DavidMFlynn/DCC-Booster/Case/CaseTop.stl

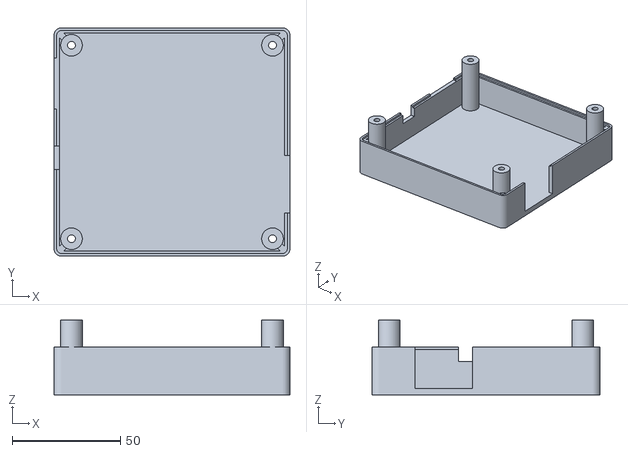
[picture p1: CAD file, 2020-07-25]
Case/CaseTop.stl
109.0 x 105.5 x 34.6
