DavidMFlynn/DCC-Booster/Case/CaseBottom.stl

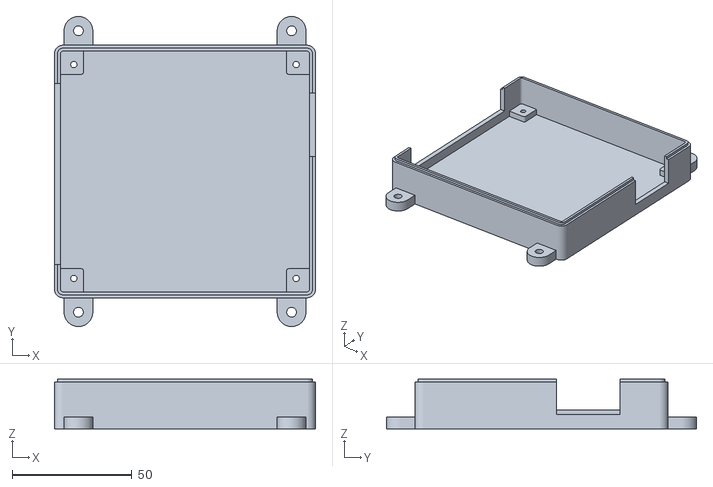
[picture p2: CAD file, 2020-07-03]
Case/CaseBottom.stl
109.0 x 129.5 x 20.8
