DavidMFlynn/DCC-Booster/DCC_Booster Rev B PCB/DCC_BoosterB.sch.pdf

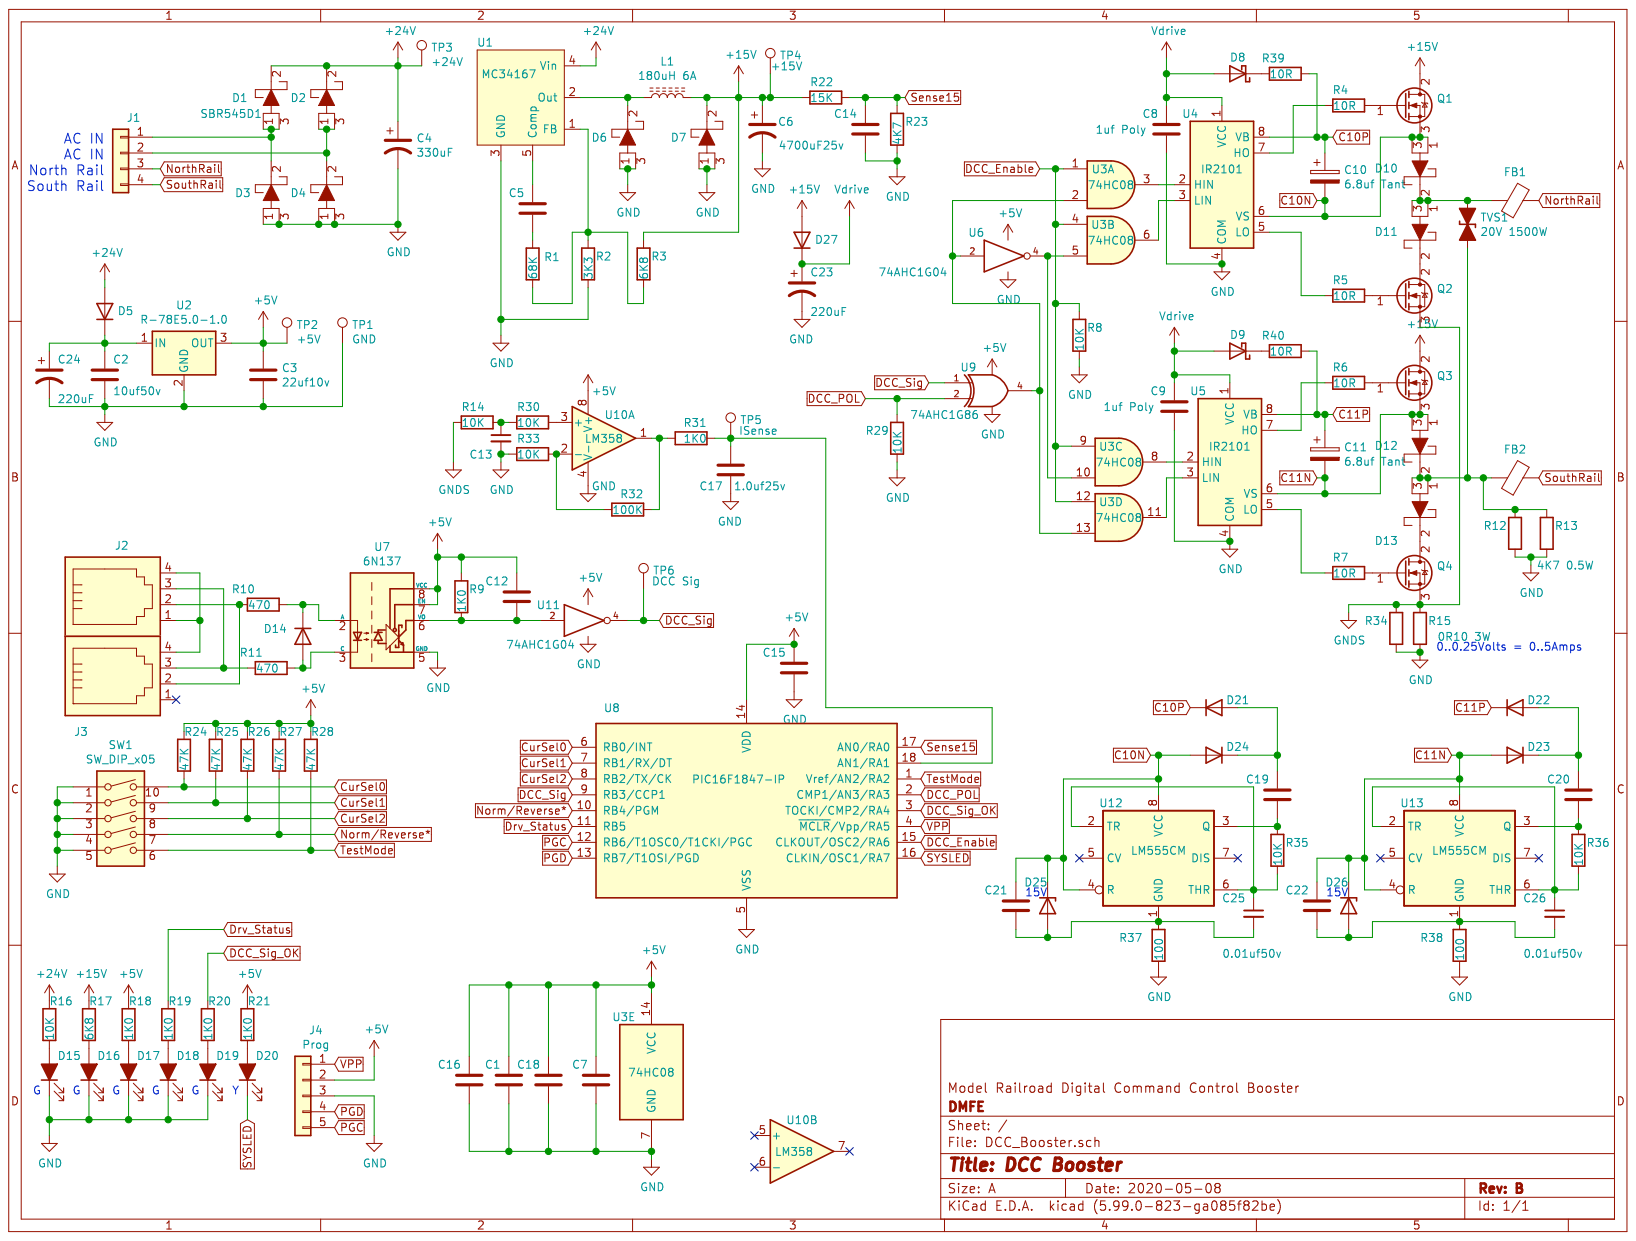
[picture p3: page 1]
