DavidMFlynn/DCC-Booster/DCC_Booster PCB/DCC_Booster.sch.pdf

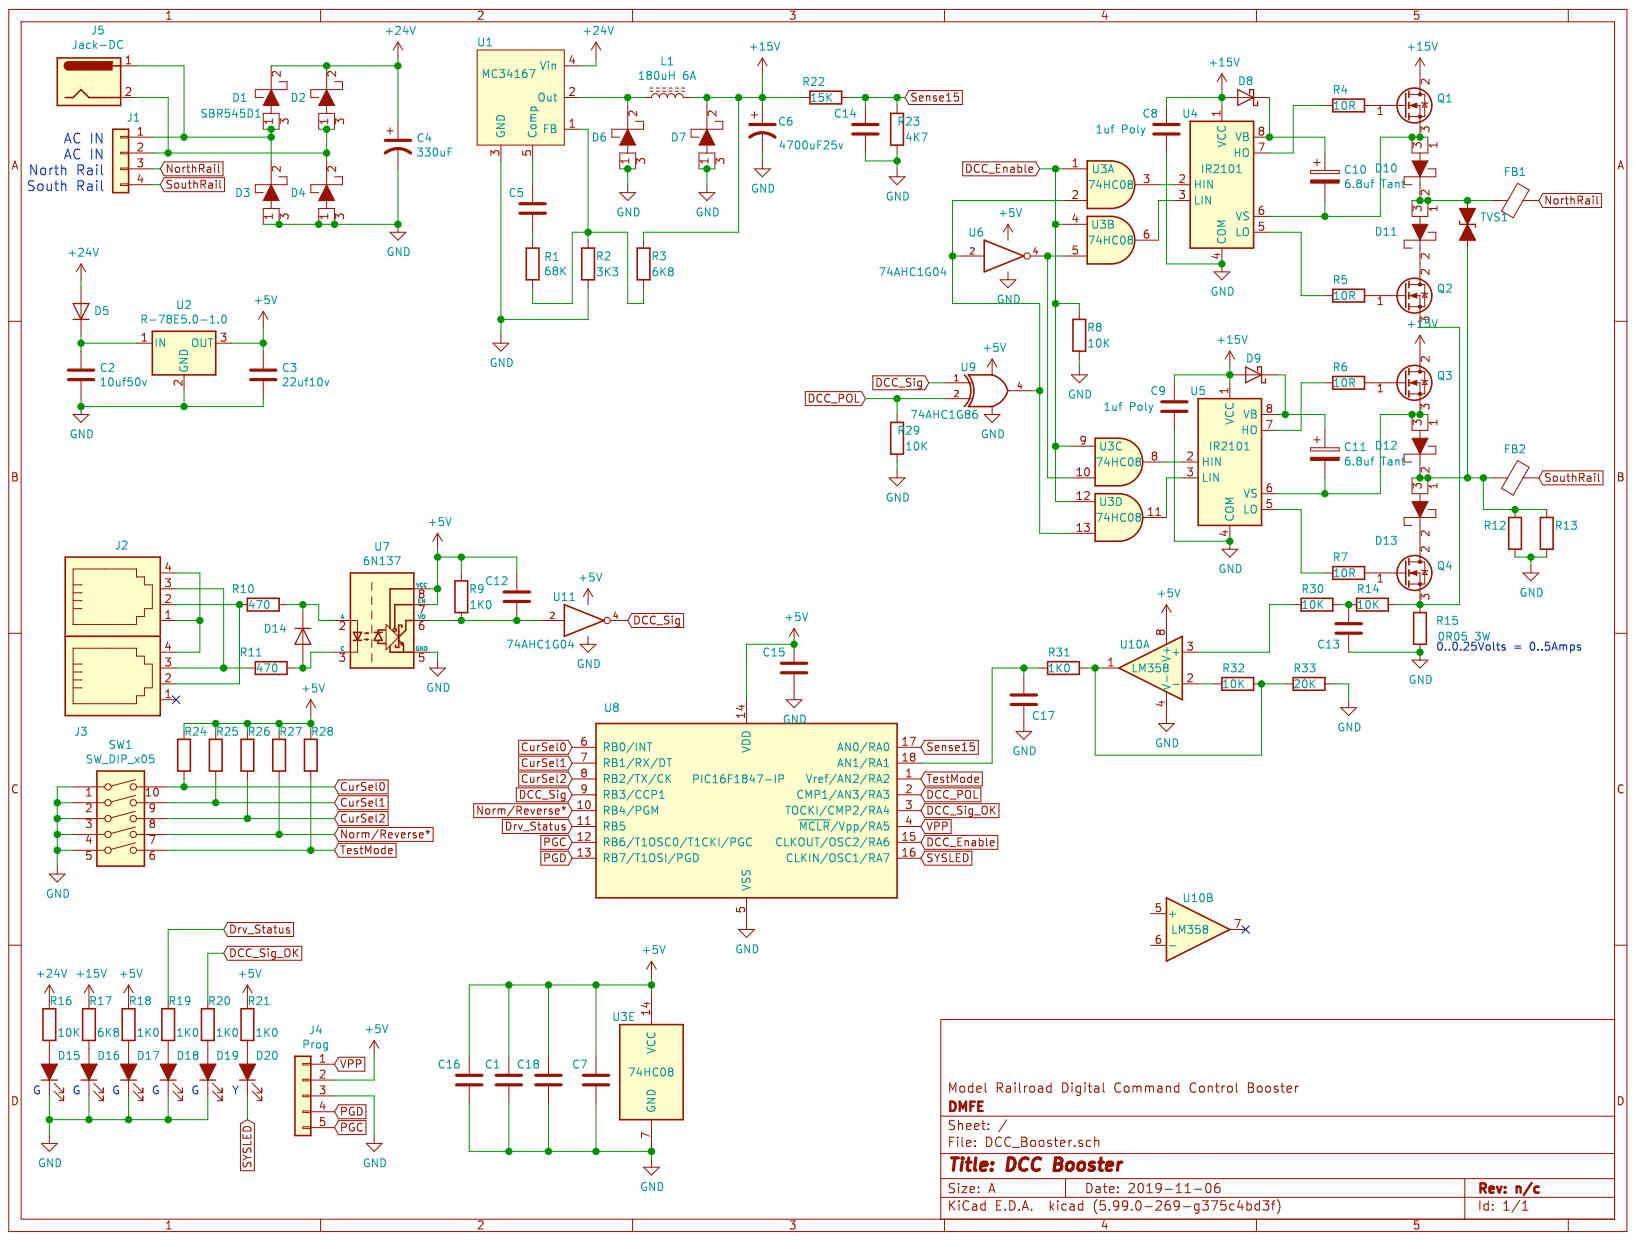
[picture p4: page 1]
