DavidMFlynn/DCC-Booster/DCC_Booster Rev C PCB/DCC_Booster.kicad_pcb

## KiCad design DCC_Booster Rev C PCB/DCC_Booster.kicad_pcb (2021-07-31)

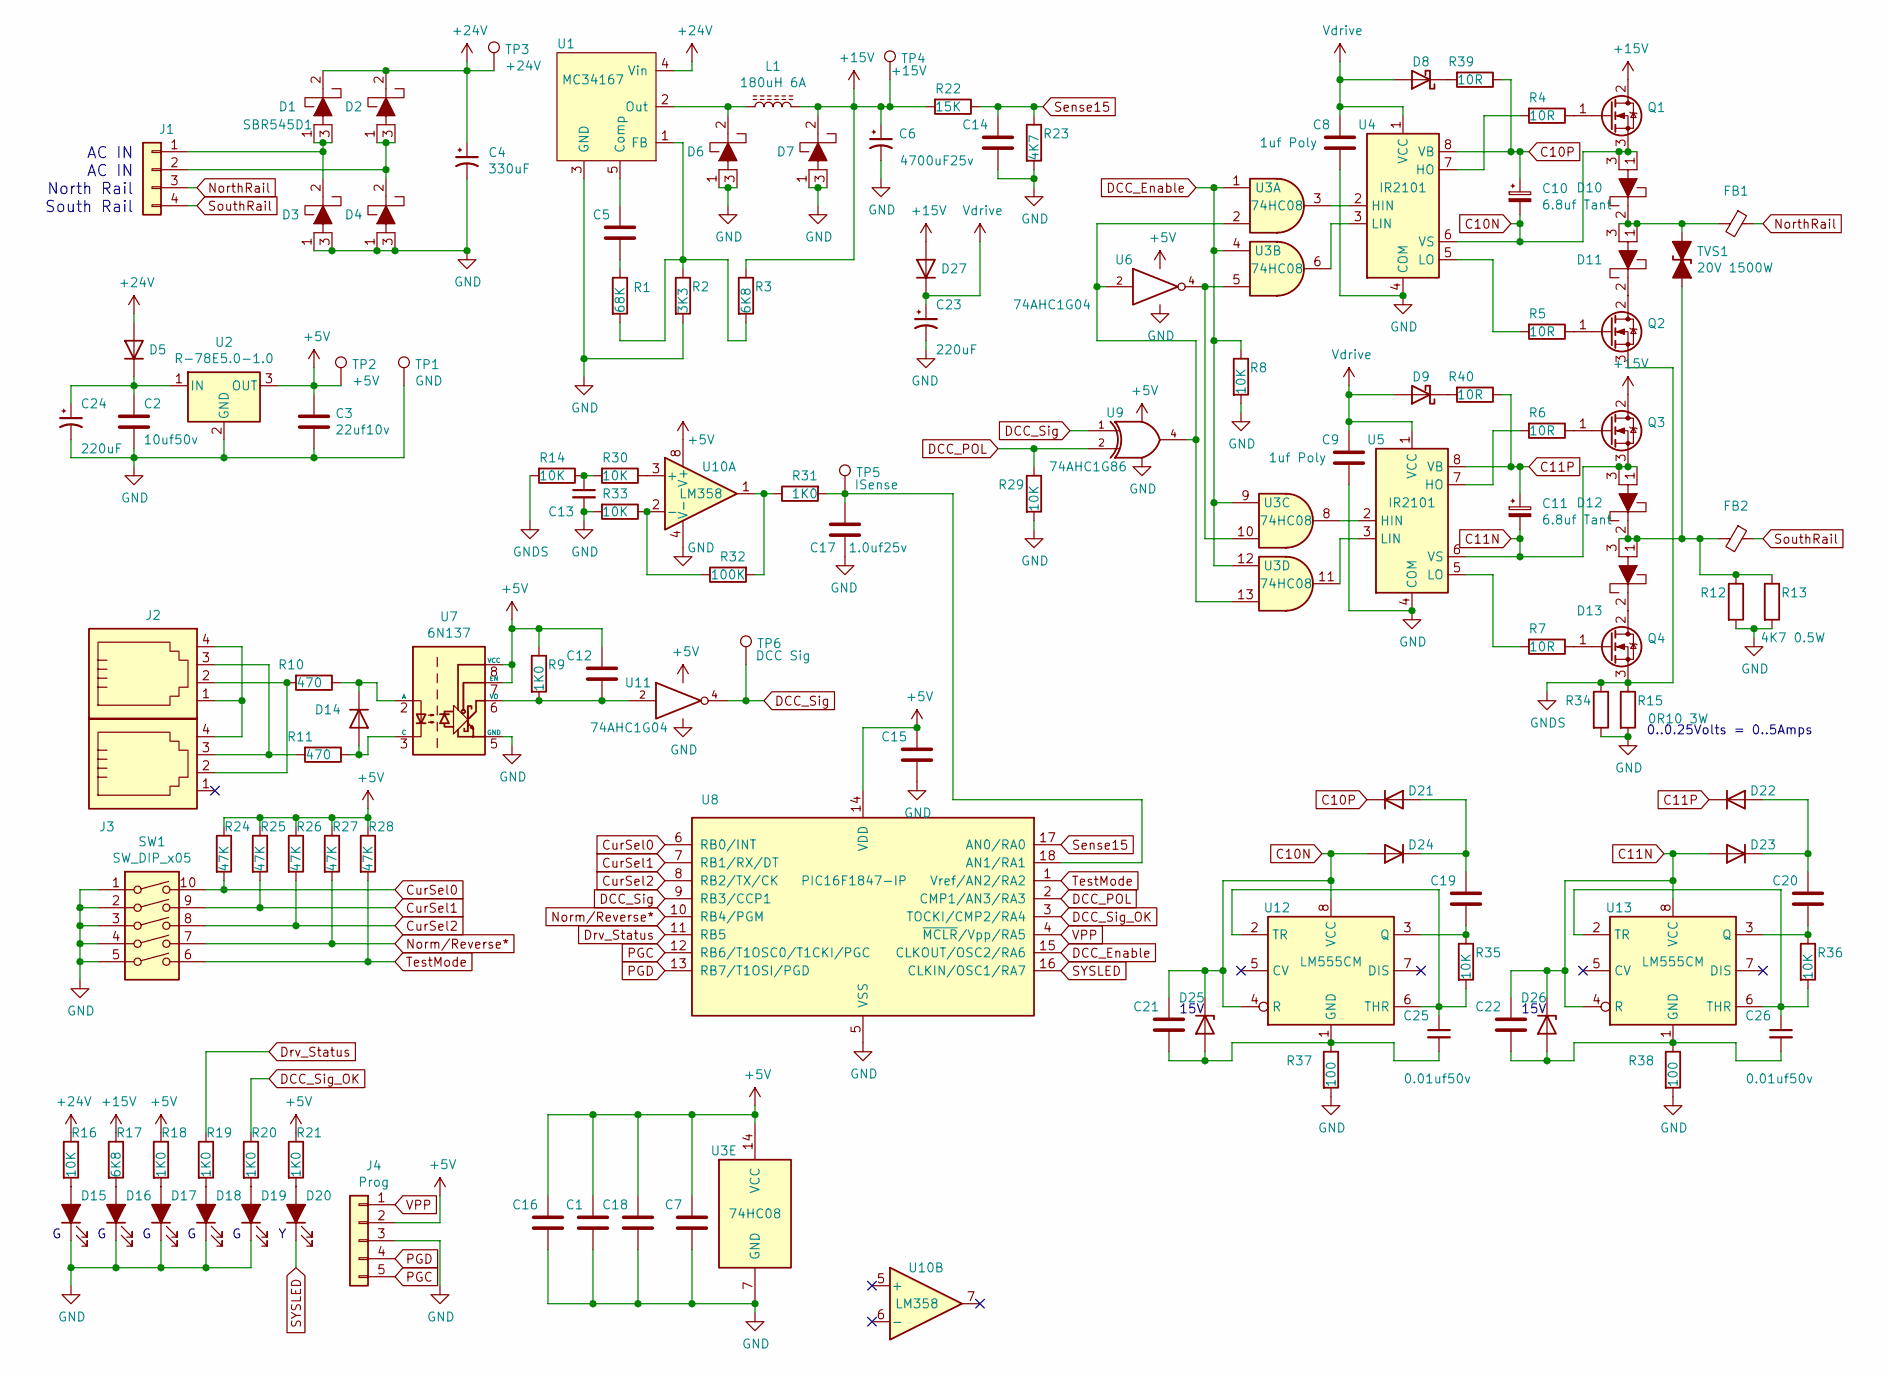
[picture p5: schematic DCC_Booster.kicad_sch, DCC Booster]

Parts:
C1, C5, C7, C12, C13, C14, C15, C16, C18, C19, C20, C21, C22: 0.1uf50v; C_0805_2012Metric_Pad1.15x1.40mm_HandSolder
C2: 10uf50v; C_1210_3225Metric_Pad1.42x2.65mm_HandSolder
C3: 22uf10v; C_1210_3225Metric_Pad1.42x2.65mm_HandSolder
C4: 330uF; CP_Radial_D18.0mm_P7.50mm
C6: 4700uF25v; CP_Radial_D18.0mm_P7.50mm
C8, C9: 1uf Poly; C_Rect_L7.0mm_W6.0mm_P5.00mm
C10, C11: 6.8uf Tant; CP_EIA-3528-21_Kemet-B_Pad1.50x2.35mm_HandSolder
C17: 1.0uf25v; C_0805_2012Metric_Pad1.15x1.40mm_HandSolder
C23, C24: 220uF; CP_Elec_10x10
C25, C26: 0.01uf50v; C_0805_2012Metric_Pad1.15x1.40mm_HandSolder
D1, D2, D3, D4, D6, D7, D10, D11, D12, D13: SBR545D1; TO-252-2
D5, D27: MRA4003T3G; D_SMA
D8, D9: B140-E3; D_SOD-123
D14: 1N4148; D_SOD-123
D15, D16, D17, D18, D19, D20: LED_ALT; LED_D3.0mm
D21, D22, D23, D24: 1N4148W; D_SOD-123
D25, D26: BZT52C15; D_SOD-123
FB1, FB2: Ferrite_Bead; L_1812_4532Metric_Pad1.30x3.40mm_HandSolder
J1: Conn_01x04; PhoenixContact_MC_1,5_4-G-5.08_1x04_P5.08mm_Horizontal
J2, J3: 4P4C; RJ9
J4: Prog; PinHeader_1x05_P2.54mm_Vertical
L1: 180uH 6A; L_Radial_D24.4mm_P23.70mm_muRATA_1400series
Q1, Q2, Q3, Q4: Q_NMOS_GDS; TO-252-2
R1: 68K; R_0805_2012Metric_Pad1.15x1.40mm_HandSolder
R2: 3K3; R_0805_2012Metric_Pad1.15x1.40mm_HandSolder
R3, R17: 6K8; R_0805_2012Metric_Pad1.15x1.40mm_HandSolder
R4, R5, R6, R7, R39, R40: 10R; R_0805_2012Metric_Pad1.15x1.40mm_HandSolder
R8, R14, R16, R29, R30, R33, R35, R36: 10K; R_0805_2012Metric_Pad1.15x1.40mm_HandSolder
R9, R18, R19, R20, R21, R31: 1K0; R_0805_2012Metric_Pad1.15x1.40mm_HandSolder
R10, R11: 470; R_0805_2012Metric_Pad1.15x1.40mm_HandSolder
R12, R13: 4K7 0.5W; R_1812_4532Metric_Pad1.30x3.40mm_HandSolder
R15, R34: 0R10 3W; R_2512_6332Metric_Pad1.52x3.35mm_HandSolder
R22: 15K; R_0805_2012Metric_Pad1.15x1.40mm_HandSolder
R23: 4K7; R_0805_2012Metric_Pad1.15x1.40mm_HandSolder
R24, R25, R26, R27, R28: 47K; R_0805_2012Metric_Pad1.15x1.40mm_HandSolder
R32: 100K; R_0805_2012Metric_Pad1.15x1.40mm_HandSolder
R37, R38: 100; R_0805_2012Metric_Pad1.15x1.40mm_HandSolder
SW1: SW_DIP_x05; SW_DIP_SPSTx05_Piano_10.8x14.26mm_W7.62mm_P2.54mm
TP1: GND; TestPoint_Pad_D2.0mm
TP2: +5V; TestPoint_Pad_D2.0mm
TP3: +24V; TestPoint_Pad_D2.0mm
TP4: +15V; TestPoint_Pad_D2.0mm
TP5: ISense; TestPoint_Pad_D2.0mm
TP6: DCC Sig; TestPoint_Pad_D2.0mm
TVS1: 20V 1500W; D_SMA-SMB_Universal_Handsoldering
U1: MC34167; TO-220-5_P3.4x3.7mm_StaggerOdd_Lead3.8mm_Vertical
U2: R-78E5.0-1.0; Converter_DCDC_RECOM_R-78E-0.5_THT
U3: 74HC08; SOIC-14_3.9x8.7mm_P1.27mm
U4, U5: IR2101; SOIC-8_3.9x4.9mm_P1.27mm
U6, U11: 74AHC1G04; TSOP-5_1.65x3.05mm_P0.95mm
U7: 6N137; SOIC-8_3.9x4.9mm_P1.27mm
U8: PIC16F1847-IP; SOIC-18W_7.5x11.6mm_P1.27mm
U9: 74AHC1G86; TSOP-5_1.65x3.05mm_P0.95mm
U10: LM358; SOIC-8_3.9x4.9mm_P1.27mm
U12, U13: LM555CM; SOIC-8_3.9x4.9mm_P1.27mm

Connections:
+5V: C1.1, C3.1, C7.1, C12.1, C15.1, C16.1, C18.1, J4.2, R9.1, R18.1, R21.1, R24.1, R25.1, R26.1, R27.1, R28.1, TP2.1, U2.3 (OUT), U3.14 (VCC), U6.5 (VCC), U7.7 (EN), U7.8 (VCC), U8.14 (VDD), U9.5 (VCC), U10.8 (V+), U11.5 (VCC)
+15V: C6.1, D7.2 (K), D27.2 (A), L1.2, Q1.2 (D), Q3.2 (D), R3.1, R17.1, R22.2, TP4.1
+24V: C4.1, D1.2 (K), D2.2 (K), D5.2 (A), R16.1, TP3.1, U1.4 (Vin)
C10N: C10.2, C21.1, D10.1 (A), D10.3 (A), D24.2 (A), D25.1 (K), Q1.3 (S), U4.6 (VS), U12.4 (R), U12.8 (VCC)
C10P: C10.1, D21.1 (K), R39.1, U4.8 (VB)
C11N: C11.2, C22.1, D12.1 (A), D12.3 (A), D23.2 (A), D26.1 (K), Q3.3 (S), U5.6 (VS), U13.4 (R), U13.8 (VCC)
C11P: C11.1, D22.1 (K), R40.1, U5.8 (VB)
CurSel0: R24.2, SW1.10, U8.6 (RB0/INT)
CurSel1: R25.2, SW1.9, U8.7 (RB1/RX/DT)
CurSel2: R26.2, SW1.8, U8.8 (RB2/TX/CK)
DCC_Enable: R8.1, U3.1, U3.4, U3.9, U3.12, U8.15 (CLKOUT/OSC2/RA6)
DCC_POL: R29.1, U8.2 (CMP1/AN3/RA3), U9.2
DCC_Sig: TP6.1, U8.9 (RB3/CCP1), U9.1, U11.4
DCC_Sig_OK: R20.1, U8.3 (TOCKI/CMP2/RA4)
Drv_Status: R19.1, U8.11 (RB5)
GND: C1.2, C2.2, C3.2, C4.2, C6.2, C7.2, C8.2, C9.2, C13.2, C14.2, C15.2, C16.2, C17.2, C18.2, C23.2, C24.2, D3.1 (A), D3.3 (A), D4.1 (A), D4.3 (A), D6.1 (A), D6.3 (A), D7.1 (A), D7.3 (A), D15.1 (K), D16.1 (K), D17.1 (K), D18.1 (K), D19.1 (K), J4.3, R2.2, R8.2, R12.2, R13.2, R15.2, R23.2, R29.2, R33.2, R34.2, R37.2, R38.2, SW1.1, SW1.2, SW1.3, SW1.4, SW1.5, TP1.1, U1.3 (GND), U2.2 (GND), U3.7 (GND), U4.4 (COM), U5.4 (COM), U6.3 (GND), U7.5 (GND), U8.5 (VSS), U9.3 (GND), U10.4 (V-), U11.3 (GND); also elsewhere on the board
GNDS: Q2.3 (S), Q4.3 (S), R14.2, R15.1, R34.1
unnamed: C2.1, C24.1, D5.1 (K), U2.1 (IN)
unnamed: C5.1, U1.5 (Comp)
unnamed: C5.2, R1.1
unnamed: C12.2, R9.2, U7.6 (VO), U11.2
unnamed: C13.1, R14.1, R30.2
unnamed: C17.1, R31.2, TP5.1, U8.18 (AN1/RA1)
unnamed: C19.1, D21.2 (A), D24.1 (K)
unnamed: C19.2, R35.1, U12.3 (Q)
unnamed: C20.1, D22.2 (A), D23.1 (K)
unnamed: C20.2, R36.1, U13.3 (Q)
unnamed: C21.2, C25.2, D25.2 (A), R37.1, U12.1 (GND)
unnamed: C22.2, C26.2, D26.2 (A), R38.1, U13.1 (GND)
unnamed: C25.1, R35.2, U12.2 (TR), U12.6 (THR)
unnamed: C26.1, R36.2, U13.2 (TR), U13.6 (THR)
unnamed: D1.1 (A), D1.3 (A), D3.2 (K), J1.1
unnamed: D2.1 (A), D2.3 (A), D4.2 (K), J1.2
unnamed: D6.2 (K), L1.1, U1.2 (Out)
unnamed: D8.1 (K), R39.2
unnamed: D9.1 (K), R40.2
unnamed: D10.2 (K), D11.1 (A), D11.3 (A), FB1.2, TVS1.1 (A1)
unnamed: D11.2 (K), Q2.2 (D)
unnamed: D12.2 (K), D13.1 (A), D13.3 (A), FB2.2, R12.1, R13.1, TVS1.2 (A2)
unnamed: D13.2 (K), Q4.2 (D)
unnamed: D14.1 (K), R10.1, U7.2 (A)
unnamed: D14.2 (A), R11.1, U7.3 (C)
unnamed: D15.2 (A), R16.2
unnamed: D16.2 (A), R17.2
unnamed: D17.2 (A), R18.2
unnamed: D18.2 (A), R19.2
unnamed: D19.2 (A), R20.2
unnamed: D20.2 (A), R21.2
unnamed: J2.1, J2.4, J3.4
unnamed: J2.2, J3.2, R10.2
unnamed: J2.3, J3.3, R11.2
unnamed: Q1.1 (G), R4.1
unnamed: Q2.1 (G), R5.1
unnamed: Q3.1 (G), R6.1
unnamed: Q4.1 (G), R7.1
unnamed: R1.2, R2.1, R3.2, U1.1 (FB)
unnamed: R4.2, U4.7 (HO)
unnamed: R5.2, U4.5 (LO)
unnamed: R6.2, U5.7 (HO)
unnamed: R7.2, U5.5 (LO)
unnamed: R30.1, U10.3 (+)
unnamed: R31.1, R32.2, U10.1
unnamed: R32.1, R33.1, U10.2 (-)
unnamed: U3.3, U4.2 (HIN)
unnamed: U3.6, U4.3 (LIN)
unnamed: U3.8, U5.2 (HIN)
unnamed: U3.5, U3.10, U6.4
unnamed: U3.11, U5.3 (LIN)
unnamed: U3.2, U3.13, U6.2, U9.4
Norm/Reverse*: R27.2, SW1.7, U8.10 (RB4/PGM)
NorthRail: FB1.1, J1.3
PGC: J4.5, U8.12 (RB6/T1OSC0/T1CKI/PGC)
PGD: J4.4, U8.13 (RB7/T1OSI/PGD)
SYSLED: D20.1 (K), U8.16 (CLKIN/OSC1/RA7)
Sense15: C14.1, R22.1, R23.1, U8.17 (AN0/RA0)
SouthRail: FB2.1, J1.4
TestMode: R28.2, SW1.6, U8.1 (Vref/AN2/RA2)
VPP: J4.1, U8.4 (~MCLR/Vpp/RA5)
Vdrive: C8.1, C9.1, C23.1, D8.2 (A), D9.2 (A), D27.1 (K), U4.1 (VCC), U5.1 (VCC)

Notes on the sheet:
AC IN AC IN North Rail South Rail
15V
0..0.25Volts = 0..5Amps

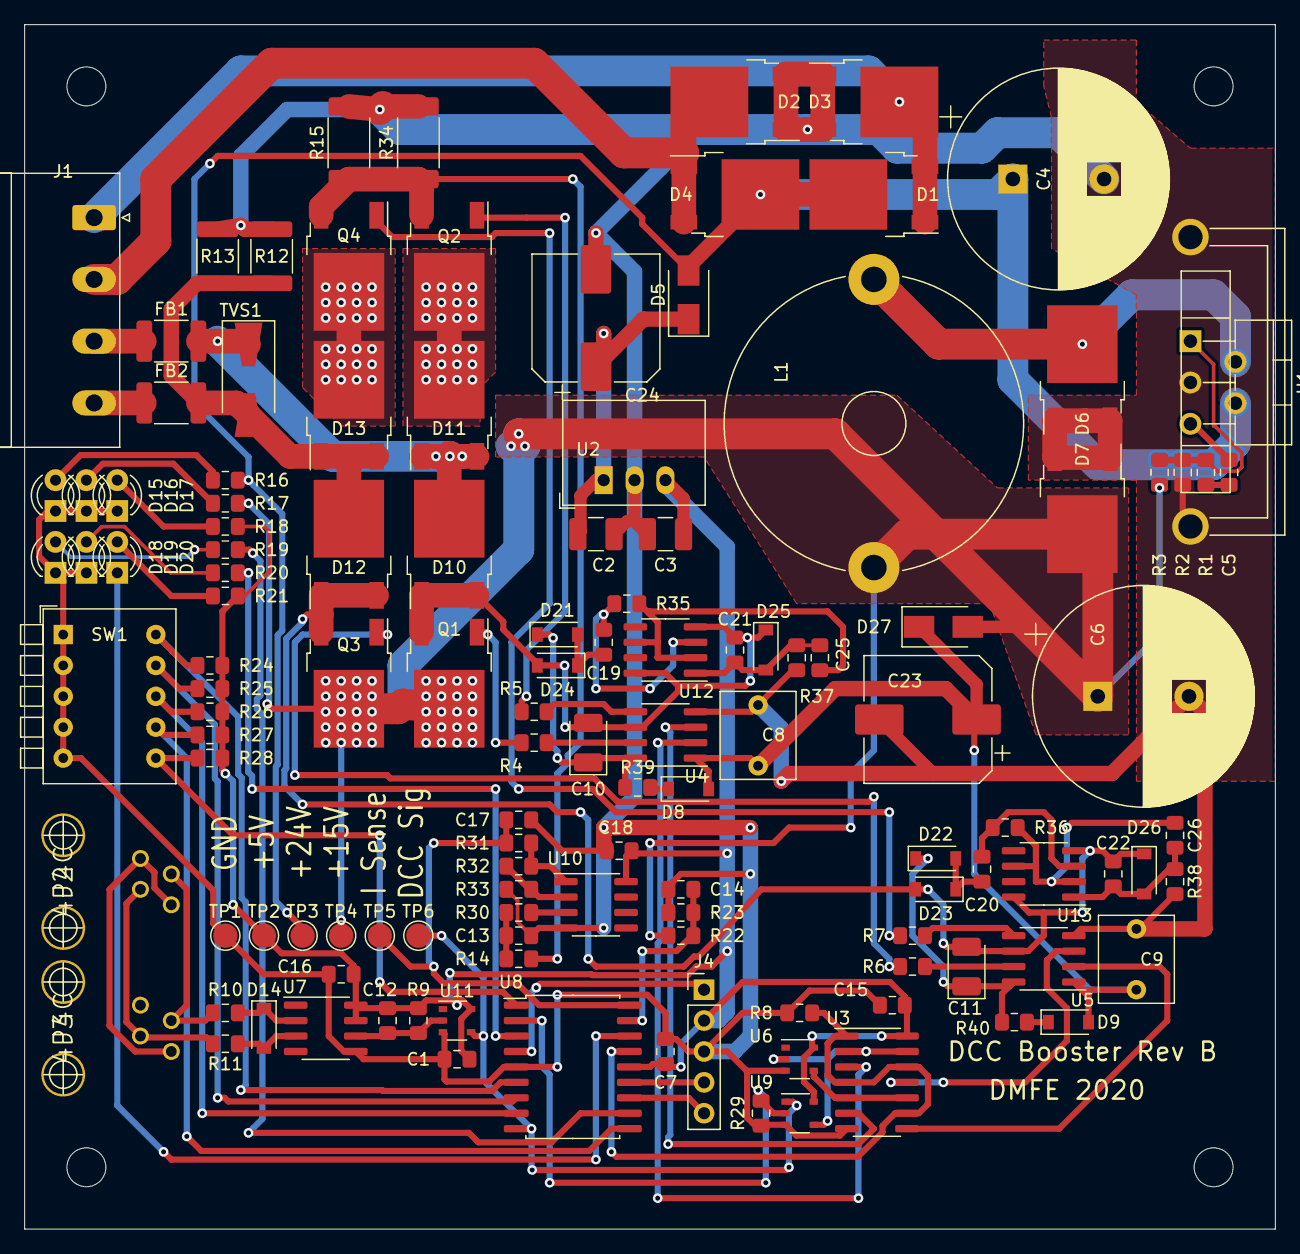
[picture p6: board DCC_Booster.kicad_pcb from above]

Board: 2 copper layers, 102.9 x 99.1 mm, 130 parts (0 on the bottom side), 79 nets.

Other parts of the board:
H1, H2, H3, H4: MountingHole_3.2mm_M3
HS1: Heatsink_Fischer_FK224xx2201_25x8.3mm

Their connections:
GND: HS1.1; also elsewhere on the board
