DavidMFlynn/DCC-Booster/(commit log)

2019-11-09 first push
    [DCC_Booster.kicad_pcb, DCC_Booster.sch]
2019-11-09 worked on PCB
    [DCC_Booster.kicad_pcb]
2019-11-10 pcb almost done
    needs labels
    [DCC_Booster.kicad_pcb]
2019-11-12 PCB ordered
    [DCC_Booster-B_Cu.gbr, DCC_Booster-B_Mask.gbr, DCC_Booster-B_SilkS.gbr, DCC_Booster-Edge_Cuts.gbr, DCC_Booster-F_Cu.gbr, DCC_Booster-F_Mask.gbr, DCC_Booster-F_SilkS.gbr, DCC_Booster.drl]
2020-03-06 started rev A
    [DCC_Booster.kicad_pcb, DCC_Booster.sch]
2020-03-07 Schematic Rev A
    [DCC_Booster.sch]
2020-03-08 Rev A PCB ordered
    [DCC_Booster-B_Cu.gbr, DCC_Booster-B_Mask.gbr, DCC_Booster-B_SilkS.gbr, DCC_Booster-Edge_Cuts.gbr, DCC_Booster-F_Cu.gbr, DCC_Booster-F_Mask.gbr, DCC_Booster-F_SilkS.gbr, DCC_Booster.drl]
2020-03-12 Rev B
    [DCC_Booster-B_Cu.gbr, DCC_Booster-B_Mask.gbr, DCC_Booster-B_SilkS.gbr, DCC_Booster-Edge_Cuts.gbr, DCC_Booster-F_Cu.gbr, DCC_Booster-F_Mask.gbr, DCC_Booster-F_SilkS.gbr, DCC_Booster.drl]
2020-03-19 Rev B PCB
    [DCC_Booster.kicad_pcb]
2020-07-25 Adding F/R
    [CaseTop.stl, DCC_Case.scad]
2021-07-31 Began Rev C PCB
    [DCC_Booster.kicad_pcb, DCC_Booster.kicad_sch, DCC_Booster.sch]
